TeamAltera/palm-to-farm/ProjectPurple/Middle/php/img/profile1.jpg

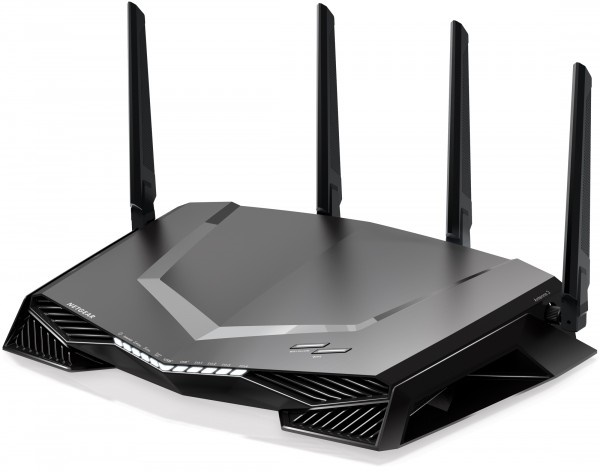
ProjectPurple/Middle/php/img/profile1.jpg
