TeamAltera/palm-to-farm/ProjectPurple/Web/FrontEnd/src/resources/img/ap.png

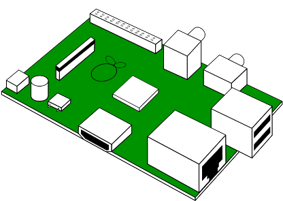
ProjectPurple/Web/FrontEnd/src/resources/img/ap.png
