TeamAltera/palm-to-farm/ProjectPurple/Web/FrontEnd/src/resources/img/dev1.jpg

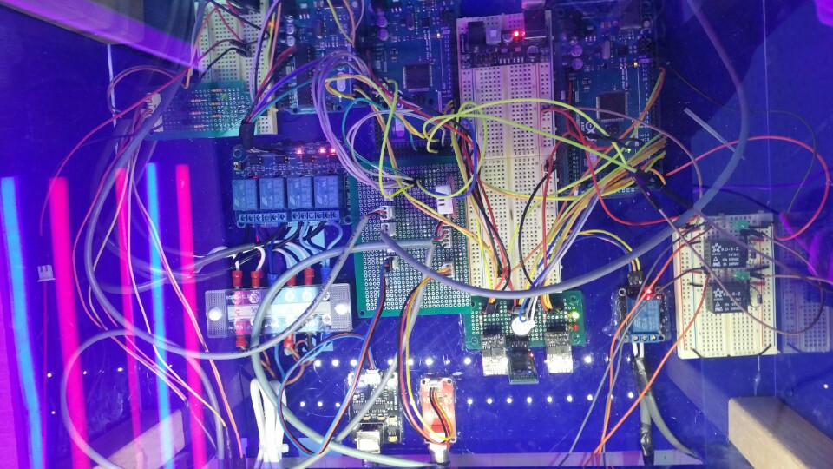
ProjectPurple/Web/FrontEnd/src/resources/img/dev1.jpg
