TeamAltera/palm-to-farm/ProjectPurple/Web/FrontEnd/src/resources/img/dev2.jpg

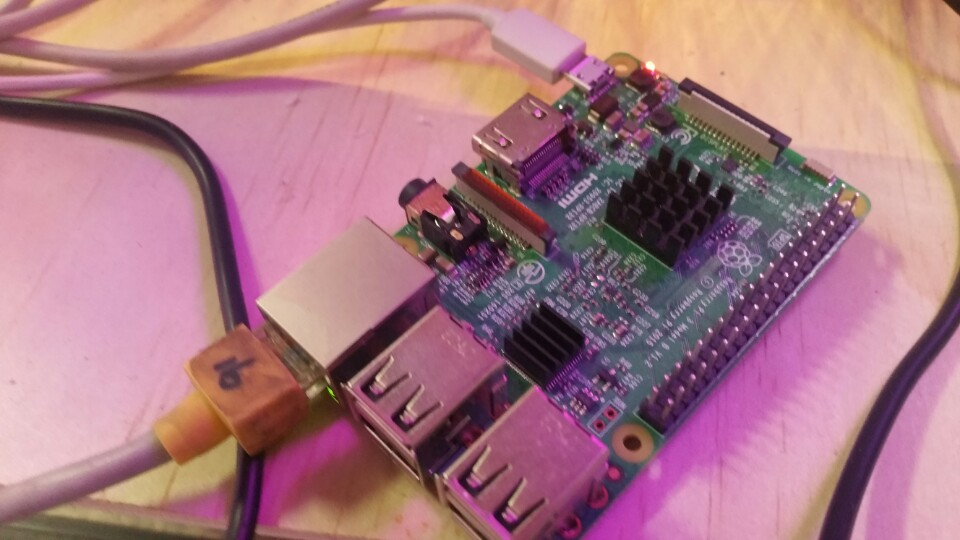
ProjectPurple/Web/FrontEnd/src/resources/img/dev2.jpg
