TeamAltera/palm-to-farm/ProjectPurple/Web/FrontEnd/src/resources/img/dev.jpg

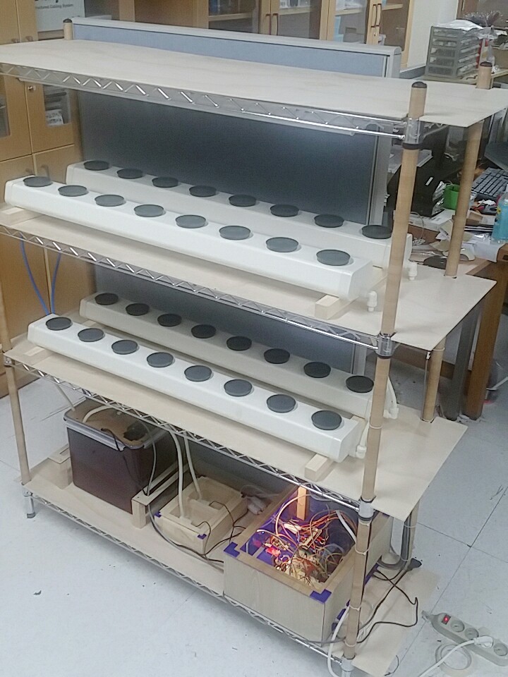
ProjectPurple/Web/FrontEnd/src/resources/img/dev.jpg
