TeamAltera/palm-to-farm/ProjectPurple/Web/FrontEnd/src/resources/img/login.jpg

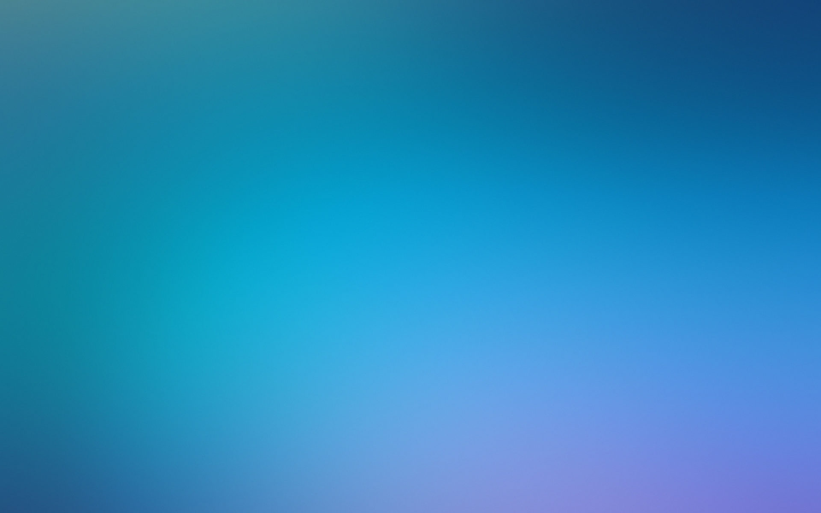
ProjectPurple/Web/FrontEnd/src/resources/img/login.jpg
