TeamAltera/palm-to-farm/ProjectPurple/Web/BackEnd/smart_farm_oauth/src/main/java/smart_farm_oauth/common/config/AuthManagerConfig.java

package smart_farm_oauth.common.config;

import org.springframework.beans.factory.annotation.Autowired;
import org.springframework.context.annotation.Bean;
import org.springframework.context.annotation.Configuration;
import org.springframework.security.authentication.AuthenticationManager;
import org.springframework.security.config.annotation.authentication.builders.AuthenticationManagerBuilder;
import org.springframework.security.config.annotation.method.configuration.EnableGlobalMethodSecurity;
import org.springframework.security.config.annotation.web.builders.HttpSecurity;
import org.springframework.security.config.annotation.web.configuration.WebSecurityConfigurerAdapter;
import org.springframework.security.core.userdetails.UserDetailsService;
import org.springframework.security.crypto.password.NoOpPasswordEncoder;
import org.springframework.security.crypto.password.PasswordEncoder;

import lombok.AllArgsConstructor;

@Configuration
@AllArgsConstructor
@EnableGlobalMethodSecurity(prePostEnabled=true)
public class AuthManagerConfig extends WebSecurityConfigurerAdapter{
	
	private UserDetailsService userDetailsService;
	
	//AuthenticationManager를 생성해주는 메서드
	/*@Override
	protected void configure(AuthenticationManagerBuilder auth) throws Exception {
		// TODO Auto-generated method stub
		auth.userDetailsService(userDetailsService);
	}*/
	
    @Override
    protected void configure(HttpSecurity http) throws Exception {
        http
                .csrf().disable()
                .anonymous().disable()
                .authorizeRequests()
                .antMatchers("/**").permitAll();
    }
	
    @Autowired
    public void globalUserDetails(AuthenticationManagerBuilder auth) throws Exception {
        auth.userDetailsService(userDetailsService);
    }
	
	@Bean
	public PasswordEncoder oauthClientPasswordEncoder() {
		// 테스트 나중에 Bcrypt로 교체해야
		return NoOpPasswordEncoder.getInstance();
	}

	//인증 관리자
	@Bean
	@Override
	public AuthenticationManager authenticationManagerBean() throws Exception {
		return super.authenticationManagerBean();
	}
}
