TeamAltera/palm-to-farm/(commit log)

2018-04-12 Commit Spring Project
2018-05-05 change device add commands
2018-05-05 Write code to send sensor data to the server.
2018-05-05 change Query Sring, fan control code.
2018-05-06 Write LED control code. (automatic, manual)
2018-05-07 Add Sample chart with chart.js
2018-05-08 Complete LED control.(automatic, manual)
2018-05-11 change Spring JDBC to mybatis(related device)
2018-05-11 change Spring JDBC to mybatis(related user and device)
2018-05-15 Branch point
    Socket.io not work
2018-05-15 change Spring JDBC to mybatis(related user)
2018-05-15 create function for sending control data & write pump control code.
2018-05-16 Add comment & Add index.php, remove.php
    change remove.php ..
    remove_pro & remove_pro_sys
    Add comment!!
    index.php : using usercode.. data submit url : 203.250.32.180:9001/device/sf/auto
2018-05-17 Create Project < hydroponics_control board >
2018-05-17 write LED Control code.(Slave Board-Control Board)
2018-05-17 write Fan Control code.(Slave Board-Control Board)
2018-05-17 complete writing a fan control code.(Slave Board-Control Board)
2018-05-21 pump_auto -> fan_auto , add test_button
2018-05-21 add comment, change Weter Level pin.
2018-05-24 added automatic pump control code.
2018-05-29 Only Slave board has state variable on automatic/manual mode. (control board -> slave board).
2018-07-26 change CORS Filter (related Authorization token)
2018-08-02 change device CRUD services
2018-08-02 device Add Delete services
2018-08-03 change Device add services
2018-08-21 add pump on off service and update SensorDTO
2018-08-21 change sql script (G_PLANT, PLANT, SENSOR_DATA)
2018-11-21 Reads ph/ec values. control ph power supply. change code for read water level.
2018-11-21 pump_run_flag -> sol_run_flag device_ip -> sfcode
2018-11-21 reconnect AP - Master board. (esp_check_connection)
2018-11-21 reconnect AP - Slave board. (case 15)
2018-11-22 complete reconnect code in master board.
2018-11-22 change spring mvc to spring boot
2018-11-22 implement spring security oauth2 server
2018-12-02 add code "join AP fail. retry.." and execute joinAP
    [hydroponics_master.ino]
2018-12-02 led, fan isolation.
2018-12-02 led, fan isolation. (in master board)
2018-12-07 change spring mvc to spring boot and more clean code
2018-12-09 add insert dataset query
