TeamAltera/palm-to-farm/(notices)

Notices in the files:
README.md:
License: MIT
